nununoisy/surface-c/README.md

# Surface-C
### By Noah Sweilem

This repository contains the KiCAD and Gerber files for the Surface-C board.

For the BOM and more information, please read [Surface-C-Documentation.pdf](https://github.com/nununoisy/surface-c/tree/master/Surface-C-Documentation.pdf)
