nununoisy/surface-c/kicad/bom.xlsx

Designator | Value | Package | Populate | MPN
C5 | 1uF | 402 | 1 | GRM155R61C105KA12D
C3,C6 | 10uF | 402 | 2 | GRM155R60G106ME44D
C1,C2,C7 | 2.2uF | 402 | 3 | GRT155C81C225KE13D
C4 | 220nF | 402 | 1 | LLL153C80J224ME14E
D1 |  | 1206 | 1 | LTW-150TK
J1 |  |  | 1 | 1054440001
R13,R14 | 3.3k | 402 | 2 | CRCW04023K30FKEDC
R26 | 100 | 402 | 1 | CRCW0402100RFKEDC
R23,R22,R21,R24,R20,R5,R9 | 100k | 402 | 7 | CRCW0402100KFKEDC
R25 | 15k | 402 | 1 | CRCW040215K0FKEDC
R1,R3,R7,R11,R2,R4,R8,R12,R15,R16,R17,R18,R19 | 1M | 402 | 13 | RCS04021M00FKED
R6,R10 | 10k | 402 | 2 | CRCW040210K0FKEDC
U2 |  | 96-BGA MICROSTAR JUNIOR | 1 | TPS65986
U1 |  | SOIC-8 | 1 | W25Q80DV
