nununoisy/surface-c/kicad/Surface-C.kicad_pcb

## KiCad design kicad/Surface-C.kicad_pcb (2018-10-20)

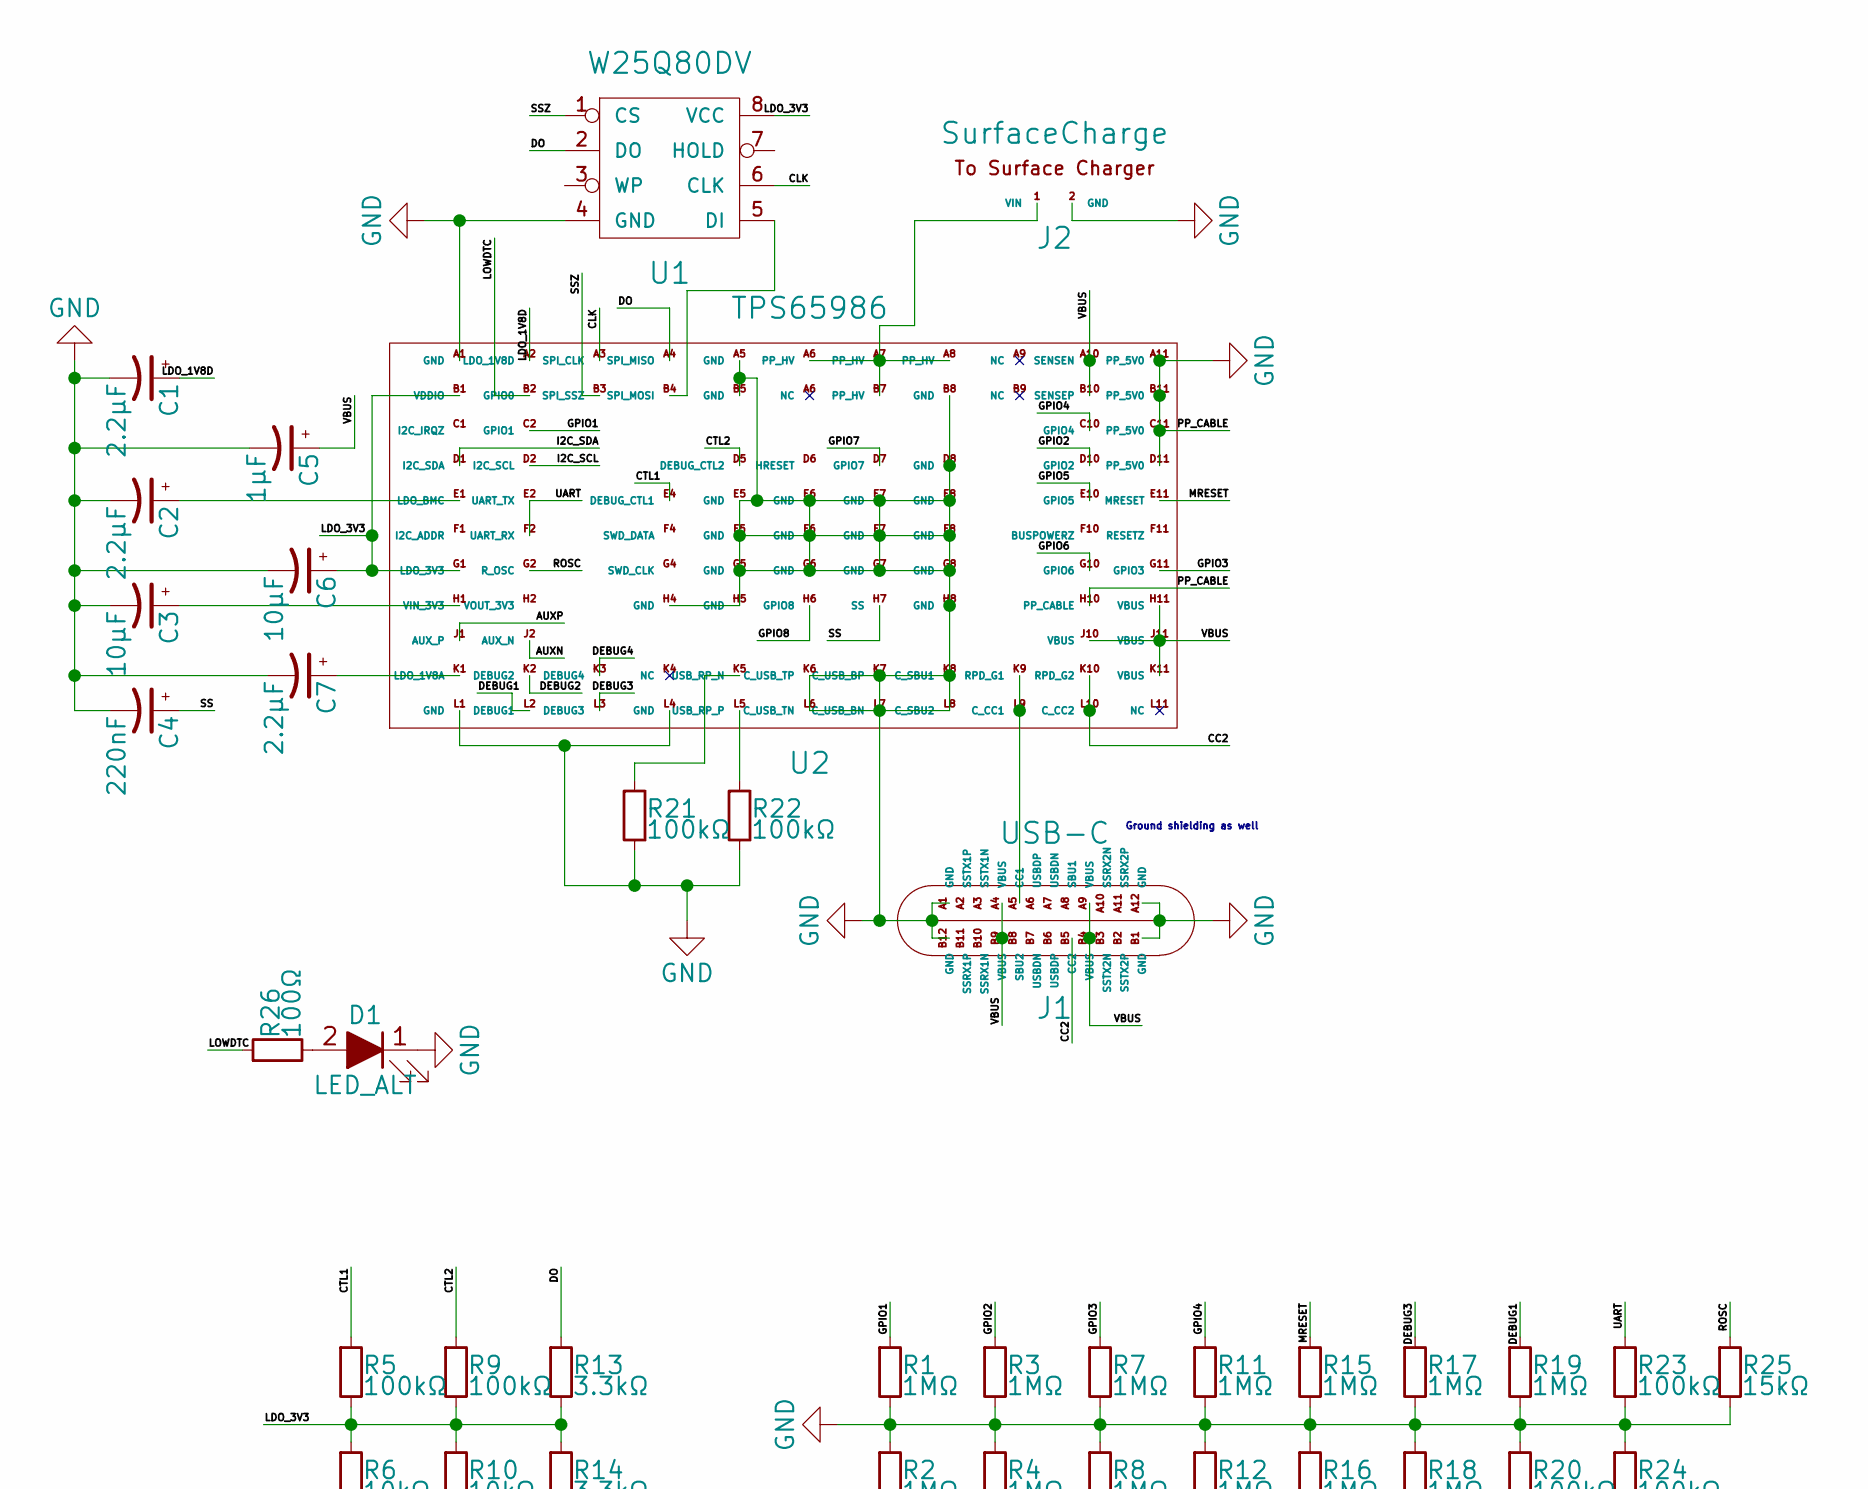
[picture p4: schematic Surface-C.sch, part in row 1, column 1]

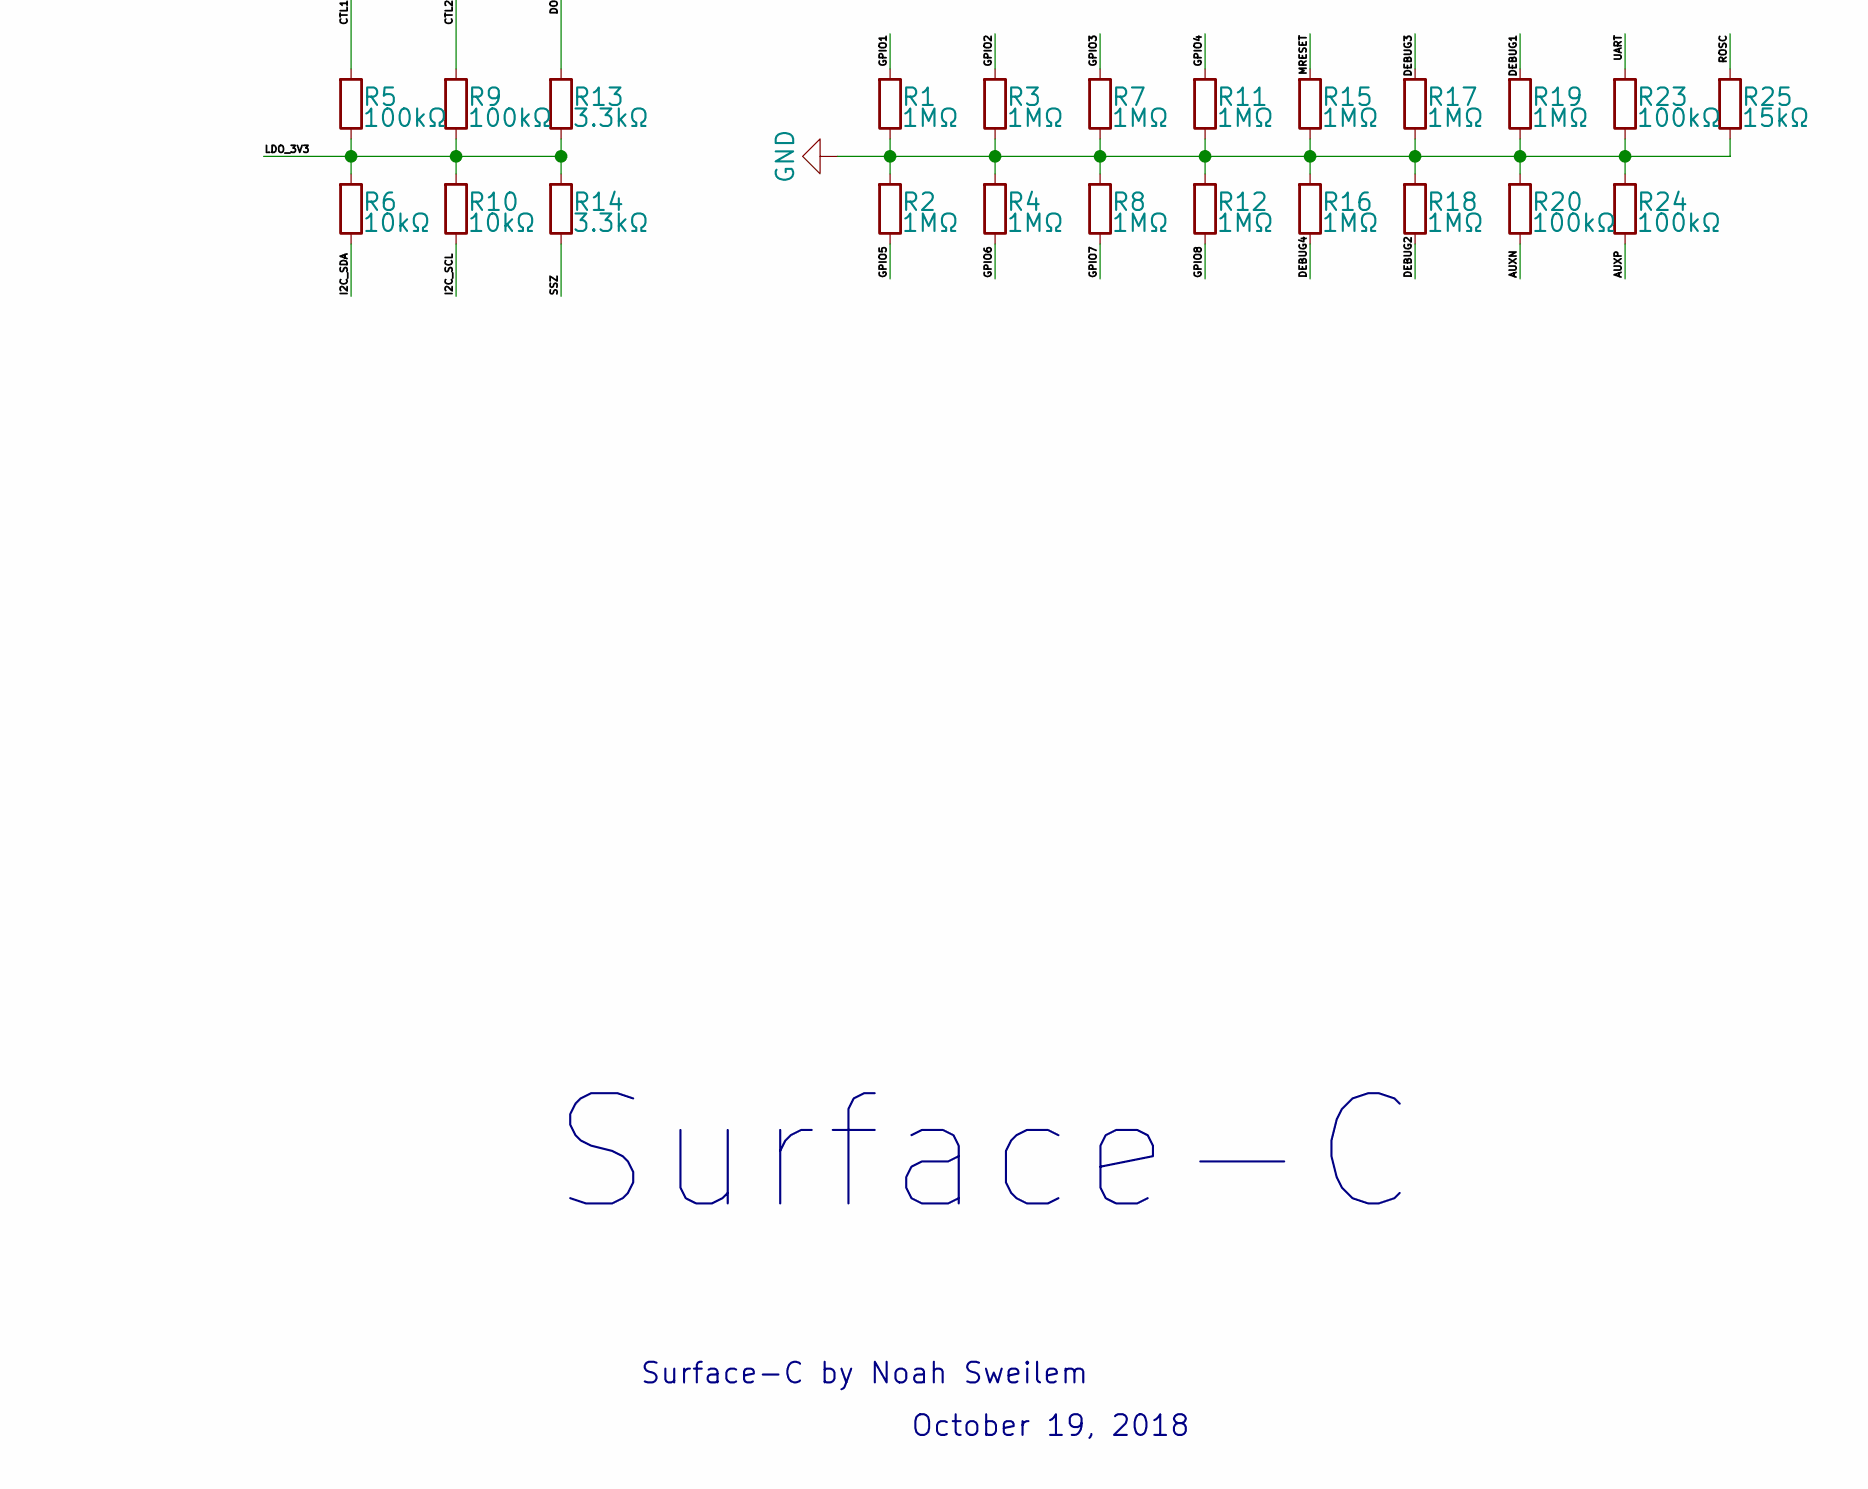
[picture p5: schematic Surface-C.sch, part in row 2, column 1]

Parts:
C1, C2, C7: 2.2μF; c_0402
C3, C6: 10μF; c_0402
C4: 220nF; c_0402
C5: 1μF; c_0402
D1: LED_ALT; LED_1206
J1: USB-C; USB-C_M
J2: SurfaceCharge; WireConnection_0.80mmDrill
R1, R2, R3, R4, R7, R8, R11, R12, R15, R16, R17, R18, R19: 1MΩ; R_0402
R5, R9, R20, R21, R22, R23, R24: 100kΩ; R_0402
R6, R10: 10kΩ; R_0402
R13, R14: 3.3kΩ; R_0402
R25: 15kΩ; R_0402
R26: 100Ω; R_0402
U1: W25Q80DV; SOIC-8_3.9x4.9mm_Pitch1.27mm
U2: TPS65986; ZQZ (S-PBGA-N96)

Connections:
/AUXN: R20.2, U2.J2 (AUX_N)
/AUXP: R24.2, U2.J1 (AUX_P)
/CC2: J1.B5 (CC2), U2.K10 (RPD_G2), U2.L10 (C_CC2)
/CLK: U1.6 (CLK), U2.A3 (SPI_CLK)
/CTL1: R5.1, U2.E4 (DEBUG_CTL1)
/CTL2: R9.1, U2.D5 (DEBUG_CTL2)
/DEBUG1: R19.1, U2.L2 (DEBUG1)
/DEBUG2: R18.2, U2.K2 (DEBUG2)
/DEBUG3: R17.1, U2.L3 (DEBUG3)
/DEBUG4: R16.2, U2.K3 (DEBUG4)
/DO: R13.1, U1.2 (DO), U2.A4 (SPI_MISO)
/GPIO1: R1.1, U2.C2 (GPIO1)
/GPIO2: R3.1, U2.D10 (GPIO2)
/GPIO3: R7.1, U2.G11 (GPIO3)
/GPIO4: R11.1, U2.C10 (GPIO4)
/GPIO5: R2.2, U2.E10 (GPIO5)
/GPIO6: R4.2, U2.G10 (GPIO6)
/GPIO7: R8.2, U2.D7 (GPIO7)
/GPIO8: R12.2, U2.H6 (GPIO8)
/I2C_SCL: R10.2, U2.D2 (I2C_SCL)
/I2C_SDA: R6.2, U2.D1 (I2C_SDA)
/LDO_1V8D: C1.1, U2.A2 (LDO_1V8D)
/LDO_3V3: C6.1, R5.2, R6.1, R9.2, R10.1, R13.2, R14.1, U1.8 (VCC), U2.B1 (VDDIO), U2.G1 (LDO_3V3)
/LOWDTC: R26.1, U2.B2 (GPIO0)
/MRESET: R15.1, U2.E11 (MRESET)
/ROSC: R25.1, U2.G2 (R_OSC)
/SS: C4.1, U2.H7 (SS)
/SSZ: R14.2, U1.1 (CS), U2.B3 (SPI_SSZ)
/UART: R23.1, U2.E2 (UART_TX), U2.F2 (UART_RX)
/VBUS: C5.1, J1.A4 (VBUS), J1.A9 (VBUS), J1.B4 (VBUS), J1.B9 (VBUS), U2.A10 (SENSEN), U2.B10 (SENSEP), U2.H11 (VBUS), U2.J10 (VBUS), U2.J11 (VBUS), U2.K11 (VBUS)
GND: C1.2, C2.2, C3.2, C4.2, C5.2, C6.2, C7.2, D1.1 (K), J1.A1 (GND), J1.A12 (GND), J1.B1 (GND), J1.B12 (GND), J2.2 (GND), R1.2, R2.1, R3.2, R4.1, R7.2, R8.1, R11.2, R12.1, R15.2, R16.1, R17.2, R18.1, R19.2, R20.1, R21.2, R22.2, R23.2, R24.1, R25.2, U1.4 (GND), U2.A1 (GND), U2.A5 (GND), U2.A11 (PP_5V0), U2.B5 (GND), U2.B8 (GND), U2.B11 (PP_5V0), U2.C11 (PP_5V0), U2.D8 (GND), U2.D11 (PP_5V0), U2.E5 (GND), U2.E6 (GND), U2.E7 (GND), U2.E8 (GND), U2.F5 (GND), U2.F6 (GND), U2.F7 (GND), U2.F8 (GND), U2.G5 (GND), U2.G6 (GND), U2.G7 (GND), U2.G8 (GND), U2.H4 (GND), U2.H5 (GND), U2.H8 (GND), U2.H10 (PP_CABLE), U2.K6 (C_USB_TP), U2.K7 (C_USB_BP), U2.K8 (C_SBU1), U2.L1 (GND), U2.L4 (GND), U2.L6 (C_USB_TN), U2.L7 (C_USB_BN), U2.L8 (C_SBU2)
unnamed: C2.1, U2.E1 (LDO_BMC)
unnamed: C3.1, U2.H1 (VIN_3V3)
unnamed: C7.1, U2.K1 (LDO_1V8A)
unnamed: D1.2 (A), R26.2
unnamed: J1.A5 (CC1), U2.K9 (RPD_G1), U2.L9 (C_CC1)
unnamed: R21.1, U2.K5 (USB_RP_N)
unnamed: R22.1, U2.L5 (USB_RP_P)
unnamed: U1.5 (DI), U2.B4 (SPI_MOSI)

Notes on the sheet:
Surface-C
Surface-C by Noah Sweilem
October 19, 2018
Ground shielding as well

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
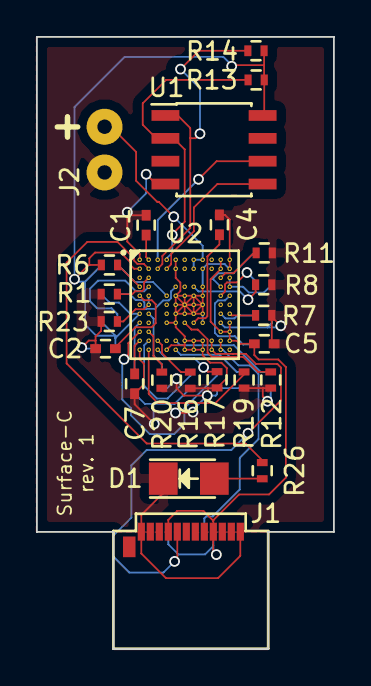
[picture p6: board Surface-C.kicad_pcb from above]

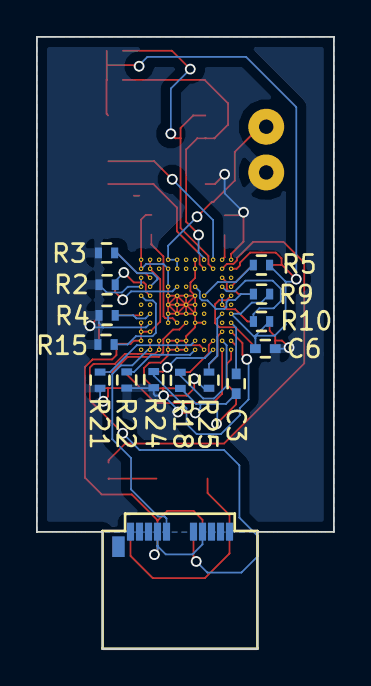
[picture p7: board Surface-C.kicad_pcb from below]

Board: 2 copper layers, 16.5 x 34.0 mm, 38 parts (14 on the bottom side), 40 nets.
